1337leets/ELM-3091-Inverse-Traffic-Light/(list of files, drawings)

Other design files:
history/1_first_version.pdsprj
history/2_with_clock_control.pdsprj
history/3_hc74_version.pdsprj
inverse_traffic_light.pdsprj
